jaiden-stipp/FPGA-Graphics-SoC/docs/benchmarks/castle-doors-001/material-preview.png

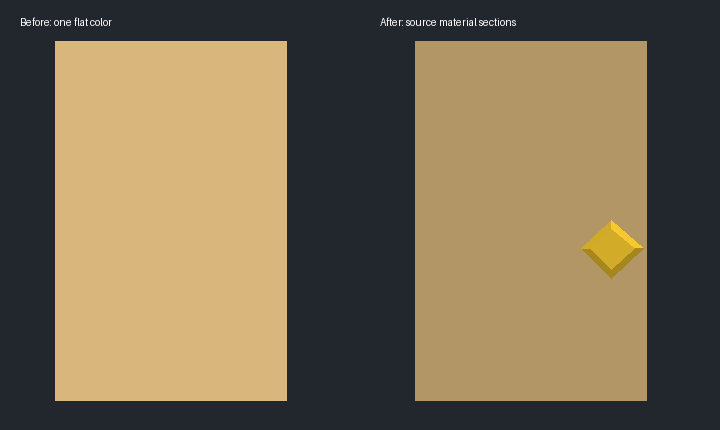
docs/benchmarks/castle-doors-001/material-preview.png
