jaiden-stipp/FPGA-Graphics-SoC/docs/benchmarks/sdram-exec-001/diagnostic-disassembly.txt

C:\Users\Orb1t\Documents\Codex\FPGA-Game-SoC\build\sdram-exec-test.elf:	file format elf32-littleriscv

Disassembly of section .boot:

00000000 <_start>:
       0: 00010117     	auipc	sp, 0x10
       4: 00010113     	mv	sp, sp
       8: 400002b7     	lui	t0, 0x40000
       c: 09c28293     	addi	t0, t0, 0x9c
      10: 0002a303     	lw	t1, 0x0(t0)
      14: 00437313     	andi	t1, t1, 0x4
      18: 00031e63     	bnez	t1, 0x34 <_start+0x34>
      1c: 400002b7     	lui	t0, 0x40000
      20: 01828293     	addi	t0, t0, 0x18
      24: dead0337     	lui	t1, 0xdead0
      28: 0c330313     	addi	t1, t1, 0xc3
      2c: 0062a023     	sw	t1, 0x0(t0)
      30: 0000006f     	j	0x30 <_start+0x30>
      34: 00000297     	auipc	t0, 0x0
      38: 06028293     	addi	t0, t0, 0x60
      3c: 00000317     	auipc	t1, 0x0
      40: 05c30313     	addi	t1, t1, 0x5c
      44: 0062f863     	bgeu	t0, t1, 0x54 <_start+0x54>
      48: 0002a023     	sw	zero, 0x0(t0)
      4c: 00428293     	addi	t0, t0, 0x4
      50: ff5ff06f     	j	0x44 <_start+0x44>
      54: 81000297     	auipc	t0, 0x81000
      58: fb028293     	addi	t0, t0, -0x50
      5c: 81000317     	auipc	t1, 0x81000
      60: fd430313     	addi	t1, t1, -0x2c
      64: 0062f863     	bgeu	t0, t1, 0x74 <_start+0x74>
      68: 0002a023     	sw	zero, 0x0(t0)
      6c: 00428293     	addi	t0, t0, 0x4
      70: ff5ff06f     	j	0x64 <_start+0x64>
      74: 80000097     	auipc	ra, 0x80000
      78: f8c080e7     	jalr	-0x74(ra) <_assets_start+0xfffffffefeffffc0>
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
80010060: 00000013     	nop
80010064: 00000013     	nop
80010068: 00000013     	nop
8001006c: 00000013     	nop
80010070: 00000013     	nop
80010074: 00000013     	nop
80010078: 00a2a023     	sw	a0, 0x0(t0)
8001007c: 00150513     	addi	a0, a0, 0x1
80010080: 00008067     	ret
