jaiden-stipp/FPGA-Graphics-SoC/docs/benchmarks/arch-upgrade-001-stage-5/probe-disassembly.txt

C:\Users\Orb1t\Documents\Codex\FPGA-Game-SoC\build\arch-stage5\probe.elf:	file format elf32-littleriscv

Disassembly of section .text:

00000000 <_start>:
       0: 00010117     	auipc	sp, 0x10
       4: 00010113     	mv	sp, sp
       8: 00002297     	auipc	t0, 0x2
       c: 46028293     	addi	t0, t0, 0x460
      10: 00003317     	auipc	t1, 0x3
      14: 48430313     	addi	t1, t1, 0x484
      18: 0062f863     	bgeu	t0, t1, 0x28 <_start+0x28>
      1c: 0002a023     	sw	zero, 0x0(t0)
      20: 00428293     	addi	t0, t0, 0x4
      24: ff5ff06f     	j	0x18 <_start+0x18>
      28: 00000097     	auipc	ra, 0x0
      2c: 320080e7     	jalr	0x320(ra) <main>
      30: 0000006f     	j	0x30 <_start+0x30>

00000034 <geometry_transform>:
      34: 400002b7     	lui	t0, 0x40000
      38: 09c2a883     	lw	a7, 0x9c(t0)
      3c: 0028f313     	andi	t1, a7, 0x2
      40: 00031663     	bnez	t1, 0x4c <geometry_transform+0x18>
      44: 00000513     	li	a0, 0x0
      48: 00008067     	ret
      4c: 00050893     	mv	a7, a0
      50: f7f58313     	addi	t1, a1, -0x81
      54: f8000393     	li	t2, -0x80
      58: fff00513     	li	a0, -0x1
      5c: 16736263     	bltu	t1, t2, 0x1c0 <geometry_transform+0x18c>
      60: 1002a303     	lw	t1, 0x100(t0)
      64: 475703b7     	lui	t2, 0x47570
      68: 10138393     	addi	t2, t2, 0x101
      6c: 14731a63     	bne	t1, t2, 0x1c0 <geometry_transform+0x18c>
      70: 00200313     	li	t1, 0x2
      74: 400003b7     	lui	t2, 0x40000
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
     730: 04c12d83     	lw	s11, 0x4c(sp)
     734: 08010113     	addi	sp, sp, 0x80
     738: 00008067     	ret
     73c: fff00513     	li	a0, -0x1
     740: fc1ff06f     	j	0x700 <main+0x3b8>

00000744 <fixed_mul>:
     744: 02b50533     	<unknown>
     748: 00008067     	ret
