jaiden-stipp/FPGA-Graphics-SoC/docs/benchmarks/arch-upgrade-001-stage-2b/dma-local-normal-disassembly.txt

build/mario-castle-sdram-direct-dma-mul.elf:	file format elf32-littleriscv

Disassembly of section .text:

00000000 <_start>:
       0: 00010117     	auipc	sp, 0x10
       4: 00010113     	mv	sp, sp
       8: 00007297     	auipc	t0, 0x7
       c: a5028293     	addi	t0, t0, -0x5b0
      10: 00009317     	auipc	t1, 0x9
      14: 82c30313     	addi	t1, t1, -0x7d4
      18: 0062f863     	bgeu	t0, t1, 0x28 <_start+0x28>
      1c: 0002a023     	sw	zero, 0x0(t0)
      20: 00428293     	addi	t0, t0, 0x4
      24: ff5ff06f     	j	0x18 <_start+0x18>
      28: 00002097     	auipc	ra, 0x2
      2c: 3c4080e7     	jalr	0x3c4(ra) <main>
      30: 0000006f     	j	0x30 <_start+0x30>

00000034 <gfx_command>:
      34: fb010113     	addi	sp, sp, -0x50
      38: 04112623     	sw	ra, 0x4c(sp)
      3c: 04812423     	sw	s0, 0x48(sp)
      40: 04912223     	sw	s1, 0x44(sp)
      44: 05212023     	sw	s2, 0x40(sp)
      48: 03312e23     	sw	s3, 0x3c(sp)
      4c: 03412c23     	sw	s4, 0x38(sp)
      50: 03512a23     	sw	s5, 0x34(sp)
      54: 03612823     	sw	s6, 0x30(sp)
      58: 03712623     	sw	s7, 0x2c(sp)
      5c: 03812423     	sw	s8, 0x28(sp)
      60: 03912223     	sw	s9, 0x24(sp)
      64: 03a12023     	sw	s10, 0x20(sp)
      68: 01b12e23     	sw	s11, 0x1c(sp)
      6c: 00058913     	mv	s2, a1
      70: 000075b7     	lui	a1, 0x7
      74: a585c583     	lbu	a1, -0x5a8(a1)
      78: 28058663     	beqz	a1, 0x304 <gfx_command+0x2d0>
      7c: 00007737     	lui	a4, 0x7
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
    695c: 00008067     	ret
    6960: 0c250513     	addi	a0, a0, 0xc2
    6964: 07010113     	addi	sp, sp, 0x70
    6968: 00008067     	ret
    696c: dead1537     	lui	a0, 0xdead1
    6970: 0d050513     	addi	a0, a0, 0xd0
    6974: 07010113     	addi	sp, sp, 0x70
    6978: 00008067     	ret
