jaiden-stipp/FPGA-Graphics-SoC/docs/benchmarks/arch-upgrade-001-stage-2b/packed-normal-disassembly.txt

build/mario-castle-sdram-direct-packed-mul.elf:	file format elf32-littleriscv

Disassembly of section .text:

00000000 <_start>:
       0: 00010117     	auipc	sp, 0x10
       4: 00010113     	mv	sp, sp
       8: 00006297     	auipc	t0, 0x6
       c: 6d428293     	addi	t0, t0, 0x6d4
      10: 00008317     	auipc	t1, 0x8
      14: 49830313     	addi	t1, t1, 0x498
      18: 0062f863     	bgeu	t0, t1, 0x28 <_start+0x28>
      1c: 0002a023     	sw	zero, 0x0(t0)
      20: 00428293     	addi	t0, t0, 0x4
      24: ff5ff06f     	j	0x18 <_start+0x18>
      28: 00002097     	auipc	ra, 0x2
      2c: 048080e7     	jalr	0x48(ra) <main>
      30: 0000006f     	j	0x30 <_start+0x30>

00000034 <gfx_command>:
      34: fe010113     	addi	sp, sp, -0x20
      38: 00812e23     	sw	s0, 0x1c(sp)
      3c: 00912c23     	sw	s1, 0x18(sp)
      40: 01212a23     	sw	s2, 0x14(sp)
      44: 000066b7     	lui	a3, 0x6
      48: 6dc6c703     	lbu	a4, 0x6dc(a3)
      4c: 400006b7     	lui	a3, 0x40000
      50: 01468693     	addi	a3, a3, 0x14
      54: 06070463     	beqz	a4, 0xbc <gfx_command+0x88>
      58: 00000813     	li	a6, 0x0
      5c: 00000793     	li	a5, 0x0
      60: 00000313     	li	t1, 0x0
      64: 00006737     	lui	a4, 0x6
      68: 04700893     	li	a7, 0x47
      6c: 04600f93     	li	t6, 0x46
      70: 00200413     	li	s0, 0x2
      74: 00c109a3     	sb	a2, 0x13(sp)
      78: 000104b7     	lui	s1, 0x10
      7c: 00f10393     	addi	t2, sp, 0xf
      80: 0000fe37     	lui	t3, 0xf
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
    65e0: 00008067     	ret
    65e4: 0c250513     	addi	a0, a0, 0xc2
    65e8: 07010113     	addi	sp, sp, 0x70
    65ec: 00008067     	ret
    65f0: dead1537     	lui	a0, 0xdead1
    65f4: 0d050513     	addi	a0, a0, 0xd0
    65f8: 07010113     	addi	sp, sp, 0x70
    65fc: 00008067     	ret
