jaiden-stipp/FPGA-Graphics-SoC/docs/benchmarks/arch-upgrade-001-stage-2b-staging/probe-disassembly.txt

C:\Users\Orb1t\Documents\Codex\FPGA-Game-SoC\build\arch-stage2b-staging\probe.elf:	file format elf32-littleriscv

Disassembly of section .text:

00000000 <_start>:
       0: 00010117     	auipc	sp, 0x10
       4: 00010113     	mv	sp, sp
       8: 0000b297     	auipc	t0, 0xb
       c: fe428293     	addi	t0, t0, -0x1c
      10: 0000e317     	auipc	t1, 0xe
      14: 95030313     	addi	t1, t1, -0x6b0
      18: 0062f863     	bgeu	t0, t1, 0x28 <_start+0x28>
      1c: 0002a023     	sw	zero, 0x0(t0)
      20: 00428293     	addi	t0, t0, 0x4
      24: ff5ff06f     	j	0x18 <_start+0x18>
      28: 00000097     	auipc	ra, 0x0
      2c: 3ac080e7     	jalr	0x3ac(ra) <main>
      30: 0000006f     	j	0x30 <_start+0x30>

00000034 <gfx_command>:
      34: fe010113     	addi	sp, sp, -0x20
      38: 00812e23     	sw	s0, 0x1c(sp)
      3c: 00912c23     	sw	s1, 0x18(sp)
      40: 01212a23     	sw	s2, 0x14(sp)
      44: 0000d6b7     	lui	a3, 0xd
      48: 40c6c703     	lbu	a4, 0x40c(a3)
      4c: 400006b7     	lui	a3, 0x40000
      50: 01468693     	addi	a3, a3, 0x14
      54: 06070463     	beqz	a4, 0xbc <gfx_command+0x88>
      58: 00000813     	li	a6, 0x0
      5c: 00000793     	li	a5, 0x0
      60: 00000313     	li	t1, 0x0
      64: 0000d737     	lui	a4, 0xd
      68: 04700893     	li	a7, 0x47
      6c: 04600f93     	li	t6, 0x46
      70: 00200413     	li	s0, 0x2
      74: 00c109a3     	sb	a2, 0x13(sp)
      78: 000104b7     	lui	s1, 0x10
      7c: 00f10393     	addi	t2, sp, 0xf
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
     3b8: 00b685b3     	add	a1, a3, a1
     3bc: 08a5ac23     	sw	a0, 0x98(a1)
     3c0: 0006a503     	lw	a0, 0x0(a3)
     3c4: 00153513     	seqz	a0, a0
     3c8: fff50513     	addi	a0, a0, -0x1
     3cc: 00c56533     	or	a0, a0, a2
     3d0: dbdff06f     	j	0x18c <gfx_command+0x158>
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
