jaiden-stipp/FPGA-Graphics-SoC/docs/benchmarks/integer-mul-001/firmware-disassembly.txt

build/mario-castle-sdram-direct-profile-detail-mul.elf:	file format elf32-littleriscv

Disassembly of section .text:

00000000 <_start>:
       0: 00010117     	auipc	sp, 0x10
       4: 00010113     	mv	sp, sp
       8: 00007297     	auipc	t0, 0x7
       c: ae028293     	addi	t0, t0, -0x520
      10: 00009317     	auipc	t1, 0x9
      14: ba430313     	addi	t1, t1, -0x45c
      18: 0062f863     	bgeu	t0, t1, 0x28 <_start+0x28>
      1c: 0002a023     	sw	zero, 0x0(t0)
      20: 00428293     	addi	t0, t0, 0x4
      24: ff5ff06f     	j	0x18 <_start+0x18>
      28: 00002097     	auipc	ra, 0x2
      2c: fac080e7     	jalr	-0x54(ra) <main>
      30: 0000006f     	j	0x30 <_start+0x30>

00000034 <gfx_command>:
      34: fe010113     	addi	sp, sp, -0x20
      38: 00812e23     	sw	s0, 0x1c(sp)
      3c: 00912c23     	sw	s1, 0x18(sp)
      40: 01212a23     	sw	s2, 0x14(sp)
      44: 00000293     	li	t0, 0x0
      48: 400006b7     	lui	a3, 0x40000
      4c: 04700793     	li	a5, 0x47
      50: 04600813     	li	a6, 0x46
      54: 00200e13     	li	t3, 0x2
      58: 00010eb7     	lui	t4, 0x10
      5c: 00f10313     	addi	t1, sp, 0xf
      60: 0000f3b7     	lui	t2, 0xf
      64: 000078b7     	lui	a7, 0x7
      68: a0c88893     	addi	a7, a7, -0x5f4
      6c: 0586a703     	lw	a4, 0x58(a3)
      70: 00f107a3     	sb	a5, 0xf(sp)
      74: 01010823     	sb	a6, 0x10(sp)
      78: 01c108a3     	sb	t3, 0x11(sp)
      7c: 00a10923     	sb	a0, 0x12(sp)
      80: 00c109a3     	sb	a2, 0x13(sp)
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
     184: 00687fb3     	and	t6, a6, t1
     188: 00bfdf93     	srli	t6, t6, 0xb
     18c: 01f88fb3     	add	t6, a7, t6
     190: 000f9483     	lh	s1, 0x0(t6)
     194: 00100f93     	li	t6, 0x1
     198: 00038413     	mv	s0, t2
     19c: 00481813     	slli	a6, a6, 0x4
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
