jaiden-stipp/FPGA-Graphics-SoC/docs/benchmarks/arch-upgrade-001-stage-0/acceptance.md

# Scoped acceptance

Deterministic shared-terrain/controller/orbit-camera preparation, complete GPU buffer capture and exact comparison are verified. Seven castle snapshots, eight authored fixtures and two repeated static Quake views are archived. Full animated game frames, actual mission transitions, physical framebuffer readback and queue-full saturation remain pending. See ../../architecture-stage-0-1.md for scope and reproduction commands.
