jaiden-stipp/FPGA-Graphics-SoC/docs/benchmarks/cache-lines-001/compiler-version.txt

clang version 21.1.6
Target: x86_64-pc-windows-msvc
Thread model: posix
InstalledDir: C:\Program Files\LLVM\bin
