jaiden-stipp/FPGA-Graphics-SoC/docs/benchmarks/arch-upgrade-001-stage-1/acceptance.md

# Promotion declined

Fractional terrain draws pass scoped arithmetic, interface, source preservation, full-terrain comparison and fitted timing checks. Both physical packing experiments regress CPU render time. They remain optional and do not replace default packing or the running game/image. Three trials per configuration, failed first fit, successful registered fit, hashes and restoration evidence are retained. See ../../architecture-stage-0-1.md for measurements, tradeoffs and remaining acceptance work.
