jaiden-stipp/FPGA-Graphics-SoC/docs/benchmarks/cache-lines-001/baseline32.fit.summary.txt

Fitter Status : Successful - Fri Oct 09 23:41:36 2026
Quartus Prime Version : 18.1.0 Build 625 09/12/2018 SJ Lite Edition
Revision Name : BurstSoC
Top-level Entity Name : de2_115_soc_top
Family : Cyclone IV E
Device : EP4CE115F29C7
Timing Models : Final
Total logic elements : 20,979 / 114,480 ( 18 % )
    Total combinational functions : 17,731 / 114,480 ( 15 % )
    Dedicated logic registers : 11,345 / 114,480 ( 10 % )
Total registers : 11377
Total pins : 109 / 529 ( 21 % )
Total virtual pins : 0
Total memory bits : 2,659,668 / 3,981,312 ( 67 % )
Embedded Multiplier 9-bit elements : 74 / 532 ( 14 % )
Total PLLs : 2 / 4 ( 50 % )
