jaiden-stipp/FPGA-Graphics-SoC/docs/benchmarks/cache-lines-001/baseline32.map.summary.txt

Analysis & Synthesis Status : Successful - Fri Oct 09 23:37:18 2026
Quartus Prime Version : 18.1.0 Build 625 09/12/2018 SJ Lite Edition
Revision Name : BurstSoC
Top-level Entity Name : de2_115_soc_top
Family : Cyclone IV E
Total logic elements : 23,577
    Total combinational functions : 17,667
    Dedicated logic registers : 11,473
Total registers : 11473
Total pins : 109
Total virtual pins : 0
Total memory bits : 2,659,668
Embedded Multiplier 9-bit elements : 74
Total PLLs : 2
