jaiden-stipp/FPGA-Graphics-SoC/docs/benchmarks/cache-lines-001/line16.sta.summary.txt

------------------------------------------------------------
Timing Analyzer Summary
------------------------------------------------------------

Type  : Slow 1200mV 85C Model Setup 'CLOCK_50'
Slack : 0.761
TNS   : 0.000

Type  : Slow 1200mV 85C Model Setup 'soc|memory|external_memory.controller|read_clock|pll|auto_generated|pll1|clk[0]'
Slack : 1.407
TNS   : 0.000

Type  : Slow 1200mV 85C Model Setup 'SDRAM_CLK'
Slack : 3.597
TNS   : 0.000

Type  : Slow 1200mV 85C Model Setup 'ENET0_TX_CLK'
Slack : 3.993
TNS   : 0.000

Type  : Slow 1200mV 85C Model Setup 'ENET0_RX_CLK'
Slack : 5.655
TNS   : 0.000

Type  : Slow 1200mV 85C Model Setup 'soc|graphics|renderer|pipeline|clock_generator|altpll_component|auto_generated|pll1|clk[0]'
Slack : 11.222
TNS   : 0.000

Type  : Slow 1200mV 85C Model Hold 'CLOCK_50'
Slack : 0.275
TNS   : 0.000

Type  : Slow 1200mV 85C Model Hold 'ENET0_RX_CLK'
Slack : 0.336
TNS   : 0.000

Type  : Slow 1200mV 85C Model Hold 'ENET0_TX_CLK'
Slack : 0.384
TNS   : 0.000

Type  : Slow 1200mV 85C Model Hold 'soc|graphics|renderer|pipeline|clock_generator|altpll_component|auto_generated|pll1|clk[0]'
Slack : 0.409
TNS   : 0.000

Type  : Slow 1200mV 85C Model Hold 'SDRAM_CLK'
Slack : 10.489
TNS   : 0.000

Type  : Slow 1200mV 85C Model Hold 'soc|memory|external_memory.controller|read_clock|pll|auto_generated|pll1|clk[0]'
Slack : 13.420
TNS   : 0.000

Type  : Slow 1200mV 85C Model Recovery 'CLOCK_50'
Slack : 3.249
TNS   : 0.000

Type  : Slow 1200mV 85C Model Removal 'CLOCK_50'
Slack : 7.535
TNS   : 0.000

Type  : Slow 1200mV 85C Model Minimum Pulse Width 'CLOCK_50'
Slack : 9.526
TNS   : 0.000

Type  : Slow 1200mV 85C Model Minimum Pulse Width 'soc|memory|external_memory.controller|read_clock|pll|auto_generated|pll1|clk[0]'
Slack : 9.798
TNS   : 0.000

Type  : Slow 1200mV 85C Model Minimum Pulse Width 'SDRAM_CLK'
Slack : 15.790
TNS   : 0.000

Type  : Slow 1200mV 85C Model Minimum Pulse Width 'soc|graphics|renderer|pipeline|clock_generator|altpll_component|auto_generated|pll1|clk[0]'
Slack : 19.572
TNS   : 0.000

Type  : Slow 1200mV 85C Model Minimum Pulse Width 'ENET0_RX_CLK'
Slack : 19.630
TNS   : 0.000

Type  : Slow 1200mV 85C Model Minimum Pulse Width 'ENET0_TX_CLK'
Slack : 19.651
TNS   : 0.000

Type  : Slow 1200mV 0C Model Setup 'CLOCK_50'
Slack : 1.474
TNS   : 0.000

Type  : Slow 1200mV 0C Model Setup 'soc|memory|external_memory.controller|read_clock|pll|auto_generated|pll1|clk[0]'
Slack : 1.938
TNS   : 0.000

Type  : Slow 1200mV 0C Model Setup 'SDRAM_CLK'
Slack : 3.940
TNS   : 0.000

Type  : Slow 1200mV 0C Model Setup 'ENET0_RX_CLK'
Slack : 6.103
TNS   : 0.000

Type  : Slow 1200mV 0C Model Setup 'ENET0_TX_CLK'
Slack : 6.469
TNS   : 0.000

Type  : Slow 1200mV 0C Model Setup 'soc|graphics|renderer|pipeline|clock_generator|altpll_component|auto_generated|pll1|clk[0]'
Slack : 13.753
TNS   : 0.000

Type  : Slow 1200mV 0C Model Hold 'CLOCK_50'
Slack : 0.287
TNS   : 0.000

Type  : Slow 1200mV 0C Model Hold 'ENET0_TX_CLK'
Slack : 0.337
TNS   : 0.000

Type  : Slow 1200mV 0C Model Hold 'ENET0_RX_CLK'
Slack : 0.340
TNS   : 0.000

Type  : Slow 1200mV 0C Model Hold 'soc|graphics|renderer|pipeline|clock_generator|altpll_component|auto_generated|pll1|clk[0]'
Slack : 0.363
TNS   : 0.000

Type  : Slow 1200mV 0C Model Hold 'SDRAM_CLK'
Slack : 10.213
TNS   : 0.000

Type  : Slow 1200mV 0C Model Hold 'soc|memory|external_memory.controller|read_clock|pll|auto_generated|pll1|clk[0]'
Slack : 12.965
TNS   : 0.000

Type  : Slow 1200mV 0C Model Recovery 'CLOCK_50'
Slack : 3.773
TNS   : 0.000

Type  : Slow 1200mV 0C Model Removal 'CLOCK_50'
Slack : 6.848
TNS   : 0.000

Type  : Slow 1200mV 0C Model Minimum Pulse Width 'CLOCK_50'
Slack : 9.556
TNS   : 0.000

Type  : Slow 1200mV 0C Model Minimum Pulse Width 'soc|memory|external_memory.controller|read_clock|pll|auto_generated|pll1|clk[0]'
Slack : 9.808
TNS   : 0.000

Type  : Slow 1200mV 0C Model Minimum Pulse Width 'SDRAM_CLK'
Slack : 15.790
TNS   : 0.000

Type  : Slow 1200mV 0C Model Minimum Pulse Width 'soc|graphics|renderer|pipeline|clock_generator|altpll_component|auto_generated|pll1|clk[0]'
Slack : 19.574
TNS   : 0.000

Type  : Slow 1200mV 0C Model Minimum Pulse Width 'ENET0_RX_CLK'
Slack : 19.651
TNS   : 0.000

Type  : Slow 1200mV 0C Model Minimum Pulse Width 'ENET0_TX_CLK'
Slack : 19.669
TNS   : 0.000

Type  : Fast 1200mV 0C Model Setup 'soc|memory|external_memory.controller|read_clock|pll|auto_generated|pll1|clk[0]'
Slack : 3.593
TNS   : 0.000

Type  : Fast 1200mV 0C Model Setup 'CLOCK_50'
Slack : 5.068
TNS   : 0.000

Type  : Fast 1200mV 0C Model Setup 'SDRAM_CLK'
Slack : 5.865
TNS   : 0.000

Type  : Fast 1200mV 0C Model Setup 'ENET0_RX_CLK'
Slack : 8.470
TNS   : 0.000

Type  : Fast 1200mV 0C Model Setup 'ENET0_TX_CLK'
Slack : 16.828
TNS   : 0.000

Type  : Fast 1200mV 0C Model Setup 'soc|graphics|renderer|pipeline|clock_generator|altpll_component|auto_generated|pll1|clk[0]'
Slack : 24.638
TNS   : 0.000

Type  : Fast 1200mV 0C Model Hold 'CLOCK_50'
Slack : 0.110
TNS   : 0.000

Type  : Fast 1200mV 0C Model Hold 'ENET0_RX_CLK'
Slack : 0.134
TNS   : 0.000

Type  : Fast 1200mV 0C Model Hold 'ENET0_TX_CLK'
Slack : 0.173
TNS   : 0.000

Type  : Fast 1200mV 0C Model Hold 'soc|graphics|renderer|pipeline|clock_generator|altpll_component|auto_generated|pll1|clk[0]'
Slack : 0.188
TNS   : 0.000

Type  : Fast 1200mV 0C Model Hold 'SDRAM_CLK'
Slack : 9.414
TNS   : 0.000

Type  : Fast 1200mV 0C Model Hold 'soc|memory|external_memory.controller|read_clock|pll|auto_generated|pll1|clk[0]'
Slack : 11.270
TNS   : 0.000

Type  : Fast 1200mV 0C Model Recovery 'CLOCK_50'
Slack : 6.881
TNS   : 0.000

Type  : Fast 1200mV 0C Model Removal 'CLOCK_50'
Slack : 3.951
TNS   : 0.000

Type  : Fast 1200mV 0C Model Minimum Pulse Width 'CLOCK_50'
Slack : 9.194
TNS   : 0.000

Type  : Fast 1200mV 0C Model Minimum Pulse Width 'soc|memory|external_memory.controller|read_clock|pll|auto_generated|pll1|clk[0]'
Slack : 9.798
TNS   : 0.000

Type  : Fast 1200mV 0C Model Minimum Pulse Width 'SDRAM_CLK'
Slack : 16.000
TNS   : 0.000

Type  : Fast 1200mV 0C Model Minimum Pulse Width 'ENET0_RX_CLK'
Slack : 19.377
TNS   : 0.000

Type  : Fast 1200mV 0C Model Minimum Pulse Width 'ENET0_TX_CLK'
Slack : 19.384
TNS   : 0.000

Type  : Fast 1200mV 0C Model Minimum Pulse Width 'soc|graphics|renderer|pipeline|clock_generator|altpll_component|auto_generated|pll1|clk[0]'
Slack : 19.614
TNS   : 0.000

------------------------------------------------------------
