jaiden-stipp/FPGA-Graphics-SoC/docs/benchmarks/cache-lines-001/line8.fit.summary.txt

Fitter Status : Successful - Sat Oct 10 00:02:12 2026
Quartus Prime Version : 18.1.0 Build 625 09/12/2018 SJ Lite Edition
Revision Name : CacheLine8SoC
Top-level Entity Name : de2_115_soc_top
Family : Cyclone IV E
Device : EP4CE115F29C7
Timing Models : Final
Total logic elements : 22,790 / 114,480 ( 20 % )
    Total combinational functions : 19,508 / 114,480 ( 17 % )
    Dedicated logic registers : 11,731 / 114,480 ( 10 % )
Total registers : 11763
Total pins : 109 / 529 ( 21 % )
Total virtual pins : 0
Total memory bits : 2,665,428 / 3,981,312 ( 67 % )
Embedded Multiplier 9-bit elements : 74 / 532 ( 14 % )
Total PLLs : 2 / 4 ( 50 % )
