jaiden-stipp/FPGA-Graphics-SoC/docs/benchmarks/cache-lines-001/line8.sta.summary.txt

------------------------------------------------------------
Timing Analyzer Summary
------------------------------------------------------------

Type  : Slow 1200mV 85C Model Setup 'CLOCK_50'
Slack : 0.653
TNS   : 0.000

Type  : Slow 1200mV 85C Model Setup 'soc|memory|external_memory.controller|read_clock|pll|auto_generated|pll1|clk[0]'
Slack : 1.409
TNS   : 0.000

Type  : Slow 1200mV 85C Model Setup 'SDRAM_CLK'
Slack : 2.985
TNS   : 0.000

Type  : Slow 1200mV 85C Model Setup 'ENET0_TX_CLK'
Slack : 4.584
TNS   : 0.000

Type  : Slow 1200mV 85C Model Setup 'ENET0_RX_CLK'
Slack : 6.019
TNS   : 0.000

Type  : Slow 1200mV 85C Model Setup 'soc|graphics|renderer|pipeline|clock_generator|altpll_component|auto_generated|pll1|clk[0]'
Slack : 12.163
TNS   : 0.000

Type  : Slow 1200mV 85C Model Hold 'CLOCK_50'
Slack : 0.284
TNS   : 0.000

Type  : Slow 1200mV 85C Model Hold 'ENET0_RX_CLK'
Slack : 0.309
TNS   : 0.000

Type  : Slow 1200mV 85C Model Hold 'ENET0_TX_CLK'
Slack : 0.387
TNS   : 0.000

Type  : Slow 1200mV 85C Model Hold 'soc|graphics|renderer|pipeline|clock_generator|altpll_component|auto_generated|pll1|clk[0]'
Slack : 0.409
TNS   : 0.000

Type  : Slow 1200mV 85C Model Hold 'SDRAM_CLK'
Slack : 10.148
TNS   : 0.000

Type  : Slow 1200mV 85C Model Hold 'soc|memory|external_memory.controller|read_clock|pll|auto_generated|pll1|clk[0]'
Slack : 13.418
TNS   : 0.000

Type  : Slow 1200mV 85C Model Recovery 'CLOCK_50'
Slack : 3.669
TNS   : 0.000

Type  : Slow 1200mV 85C Model Removal 'CLOCK_50'
Slack : 6.884
TNS   : 0.000

Type  : Slow 1200mV 85C Model Minimum Pulse Width 'CLOCK_50'
Slack : 9.524
TNS   : 0.000

Type  : Slow 1200mV 85C Model Minimum Pulse Width 'soc|memory|external_memory.controller|read_clock|pll|auto_generated|pll1|clk[0]'
Slack : 9.799
TNS   : 0.000

Type  : Slow 1200mV 85C Model Minimum Pulse Width 'SDRAM_CLK'
Slack : 15.790
TNS   : 0.000

Type  : Slow 1200mV 85C Model Minimum Pulse Width 'soc|graphics|renderer|pipeline|clock_generator|altpll_component|auto_generated|pll1|clk[0]'
Slack : 19.575
TNS   : 0.000

Type  : Slow 1200mV 85C Model Minimum Pulse Width 'ENET0_RX_CLK'
Slack : 19.630
TNS   : 0.000

Type  : Slow 1200mV 85C Model Minimum Pulse Width 'ENET0_TX_CLK'
Slack : 19.651
TNS   : 0.000

Type  : Slow 1200mV 0C Model Setup 'CLOCK_50'
Slack : 1.361
TNS   : 0.000

Type  : Slow 1200mV 0C Model Setup 'soc|memory|external_memory.controller|read_clock|pll|auto_generated|pll1|clk[0]'
Slack : 1.939
TNS   : 0.000

Type  : Slow 1200mV 0C Model Setup 'SDRAM_CLK'
Slack : 3.341
TNS   : 0.000

Type  : Slow 1200mV 0C Model Setup 'ENET0_RX_CLK'
Slack : 6.446
TNS   : 0.000

Type  : Slow 1200mV 0C Model Setup 'ENET0_TX_CLK'
Slack : 7.012
TNS   : 0.000

Type  : Slow 1200mV 0C Model Setup 'soc|graphics|renderer|pipeline|clock_generator|altpll_component|auto_generated|pll1|clk[0]'
Slack : 14.662
TNS   : 0.000

Type  : Slow 1200mV 0C Model Hold 'CLOCK_50'
Slack : 0.298
TNS   : 0.000

Type  : Slow 1200mV 0C Model Hold 'ENET0_RX_CLK'
Slack : 0.306
TNS   : 0.000

Type  : Slow 1200mV 0C Model Hold 'ENET0_TX_CLK'
Slack : 0.340
TNS   : 0.000

Type  : Slow 1200mV 0C Model Hold 'soc|graphics|renderer|pipeline|clock_generator|altpll_component|auto_generated|pll1|clk[0]'
Slack : 0.363
TNS   : 0.000

Type  : Slow 1200mV 0C Model Hold 'SDRAM_CLK'
Slack : 9.842
TNS   : 0.000

Type  : Slow 1200mV 0C Model Hold 'soc|memory|external_memory.controller|read_clock|pll|auto_generated|pll1|clk[0]'
Slack : 12.964
TNS   : 0.000

Type  : Slow 1200mV 0C Model Recovery 'CLOCK_50'
Slack : 4.273
TNS   : 0.000

Type  : Slow 1200mV 0C Model Removal 'CLOCK_50'
Slack : 6.223
TNS   : 0.000

Type  : Slow 1200mV 0C Model Minimum Pulse Width 'CLOCK_50'
Slack : 9.554
TNS   : 0.000

Type  : Slow 1200mV 0C Model Minimum Pulse Width 'soc|memory|external_memory.controller|read_clock|pll|auto_generated|pll1|clk[0]'
Slack : 9.808
TNS   : 0.000

Type  : Slow 1200mV 0C Model Minimum Pulse Width 'SDRAM_CLK'
Slack : 15.790
TNS   : 0.000

Type  : Slow 1200mV 0C Model Minimum Pulse Width 'soc|graphics|renderer|pipeline|clock_generator|altpll_component|auto_generated|pll1|clk[0]'
Slack : 19.574
TNS   : 0.000

Type  : Slow 1200mV 0C Model Minimum Pulse Width 'ENET0_RX_CLK'
Slack : 19.647
TNS   : 0.000

Type  : Slow 1200mV 0C Model Minimum Pulse Width 'ENET0_TX_CLK'
Slack : 19.667
TNS   : 0.000

Type  : Fast 1200mV 0C Model Setup 'soc|memory|external_memory.controller|read_clock|pll|auto_generated|pll1|clk[0]'
Slack : 3.594
TNS   : 0.000

Type  : Fast 1200mV 0C Model Setup 'CLOCK_50'
Slack : 5.013
TNS   : 0.000

Type  : Fast 1200mV 0C Model Setup 'SDRAM_CLK'
Slack : 5.534
TNS   : 0.000

Type  : Fast 1200mV 0C Model Setup 'ENET0_RX_CLK'
Slack : 8.756
TNS   : 0.000

Type  : Fast 1200mV 0C Model Setup 'ENET0_TX_CLK'
Slack : 17.271
TNS   : 0.000

Type  : Fast 1200mV 0C Model Setup 'soc|graphics|renderer|pipeline|clock_generator|altpll_component|auto_generated|pll1|clk[0]'
Slack : 25.212
TNS   : 0.000

Type  : Fast 1200mV 0C Model Hold 'CLOCK_50'
Slack : 0.103
TNS   : 0.000

Type  : Fast 1200mV 0C Model Hold 'ENET0_RX_CLK'
Slack : 0.106
TNS   : 0.000

Type  : Fast 1200mV 0C Model Hold 'ENET0_TX_CLK'
Slack : 0.175
TNS   : 0.000

Type  : Fast 1200mV 0C Model Hold 'soc|graphics|renderer|pipeline|clock_generator|altpll_component|auto_generated|pll1|clk[0]'
Slack : 0.187
TNS   : 0.000

Type  : Fast 1200mV 0C Model Hold 'SDRAM_CLK'
Slack : 9.228
TNS   : 0.000

Type  : Fast 1200mV 0C Model Hold 'soc|memory|external_memory.controller|read_clock|pll|auto_generated|pll1|clk[0]'
Slack : 11.268
TNS   : 0.000

Type  : Fast 1200mV 0C Model Recovery 'CLOCK_50'
Slack : 7.136
TNS   : 0.000

Type  : Fast 1200mV 0C Model Removal 'CLOCK_50'
Slack : 3.663
TNS   : 0.000

Type  : Fast 1200mV 0C Model Minimum Pulse Width 'CLOCK_50'
Slack : 9.195
TNS   : 0.000

Type  : Fast 1200mV 0C Model Minimum Pulse Width 'soc|memory|external_memory.controller|read_clock|pll|auto_generated|pll1|clk[0]'
Slack : 9.798
TNS   : 0.000

Type  : Fast 1200mV 0C Model Minimum Pulse Width 'SDRAM_CLK'
Slack : 16.000
TNS   : 0.000

Type  : Fast 1200mV 0C Model Minimum Pulse Width 'ENET0_RX_CLK'
Slack : 19.375
TNS   : 0.000

Type  : Fast 1200mV 0C Model Minimum Pulse Width 'ENET0_TX_CLK'
Slack : 19.383
TNS   : 0.000

Type  : Fast 1200mV 0C Model Minimum Pulse Width 'soc|graphics|renderer|pipeline|clock_generator|altpll_component|auto_generated|pll1|clk[0]'
Slack : 19.614
TNS   : 0.000

------------------------------------------------------------
