jaiden-stipp/FPGA-Graphics-SoC/docs/benchmarks/cache-001/cache.fit.summary.txt

Fitter Status : Successful - Fri Oct 09 15:50:12 2026
Quartus Prime Version : 18.1.0 Build 625 09/12/2018 SJ Lite Edition
Revision Name : CacheSoC
Top-level Entity Name : de2_115_soc_top
Family : Cyclone IV E
Device : EP4CE115F29C7
Timing Models : Final
Total logic elements : 20,833 / 114,480 ( 18 % )
    Total combinational functions : 17,622 / 114,480 ( 15 % )
    Dedicated logic registers : 11,290 / 114,480 ( 10 % )
Total registers : 11322
Total pins : 109 / 529 ( 21 % )
Total virtual pins : 0
Total memory bits : 2,659,668 / 3,981,312 ( 67 % )
Embedded Multiplier 9-bit elements : 66 / 532 ( 12 % )
Total PLLs : 2 / 4 ( 50 % )
