jaiden-stipp/FPGA-Graphics-SoC/docs/benchmarks/cache-001/cache.sta.summary.txt

------------------------------------------------------------
Timing Analyzer Summary
------------------------------------------------------------

Type  : Slow 1200mV 85C Model Setup 'CLOCK_50'
Slack : 0.577
TNS   : 0.000

Type  : Slow 1200mV 85C Model Setup 'soc|memory|external_memory.controller|read_clock|pll|auto_generated|pll1|clk[0]'
Slack : 1.409
TNS   : 0.000

Type  : Slow 1200mV 85C Model Setup 'SDRAM_CLK'
Slack : 3.072
TNS   : 0.000

Type  : Slow 1200mV 85C Model Setup 'ENET0_TX_CLK'
Slack : 4.161
TNS   : 0.000

Type  : Slow 1200mV 85C Model Setup 'ENET0_RX_CLK'
Slack : 6.043
TNS   : 0.000

Type  : Slow 1200mV 85C Model Setup 'soc|graphics|renderer|pipeline|clock_generator|altpll_component|auto_generated|pll1|clk[0]'
Slack : 12.165
TNS   : 0.000

Type  : Slow 1200mV 85C Model Hold 'CLOCK_50'
Slack : 0.304
TNS   : 0.000

Type  : Slow 1200mV 85C Model Hold 'ENET0_RX_CLK'
Slack : 0.322
TNS   : 0.000

Type  : Slow 1200mV 85C Model Hold 'ENET0_TX_CLK'
Slack : 0.386
TNS   : 0.000

Type  : Slow 1200mV 85C Model Hold 'soc|graphics|renderer|pipeline|clock_generator|altpll_component|auto_generated|pll1|clk[0]'
Slack : 0.408
TNS   : 0.000

Type  : Slow 1200mV 85C Model Hold 'SDRAM_CLK'
Slack : 10.292
TNS   : 0.000

Type  : Slow 1200mV 85C Model Hold 'soc|memory|external_memory.controller|read_clock|pll|auto_generated|pll1|clk[0]'
Slack : 13.418
TNS   : 0.000

Type  : Slow 1200mV 85C Model Recovery 'CLOCK_50'
Slack : 2.605
TNS   : 0.000

Type  : Slow 1200mV 85C Model Removal 'CLOCK_50'
Slack : 6.424
TNS   : 0.000

Type  : Slow 1200mV 85C Model Minimum Pulse Width 'CLOCK_50'
Slack : 9.527
TNS   : 0.000

Type  : Slow 1200mV 85C Model Minimum Pulse Width 'soc|memory|external_memory.controller|read_clock|pll|auto_generated|pll1|clk[0]'
Slack : 9.799
TNS   : 0.000

Type  : Slow 1200mV 85C Model Minimum Pulse Width 'SDRAM_CLK'
Slack : 15.790
TNS   : 0.000

Type  : Slow 1200mV 85C Model Minimum Pulse Width 'soc|graphics|renderer|pipeline|clock_generator|altpll_component|auto_generated|pll1|clk[0]'
Slack : 19.576
TNS   : 0.000

Type  : Slow 1200mV 85C Model Minimum Pulse Width 'ENET0_RX_CLK'
Slack : 19.628
TNS   : 0.000

Type  : Slow 1200mV 85C Model Minimum Pulse Width 'ENET0_TX_CLK'
Slack : 19.658
TNS   : 0.000

Type  : Slow 1200mV 0C Model Setup 'CLOCK_50'
Slack : 1.640
TNS   : 0.000

Type  : Slow 1200mV 0C Model Setup 'soc|memory|external_memory.controller|read_clock|pll|auto_generated|pll1|clk[0]'
Slack : 1.939
TNS   : 0.000

Type  : Slow 1200mV 0C Model Setup 'SDRAM_CLK'
Slack : 3.498
TNS   : 0.000

Type  : Slow 1200mV 0C Model Setup 'ENET0_RX_CLK'
Slack : 6.554
TNS   : 0.000

Type  : Slow 1200mV 0C Model Setup 'ENET0_TX_CLK'
Slack : 6.601
TNS   : 0.000

Type  : Slow 1200mV 0C Model Setup 'soc|graphics|renderer|pipeline|clock_generator|altpll_component|auto_generated|pll1|clk[0]'
Slack : 14.664
TNS   : 0.000

Type  : Slow 1200mV 0C Model Hold 'CLOCK_50'
Slack : 0.307
TNS   : 0.000

Type  : Slow 1200mV 0C Model Hold 'ENET0_RX_CLK'
Slack : 0.320
TNS   : 0.000

Type  : Slow 1200mV 0C Model Hold 'ENET0_TX_CLK'
Slack : 0.339
TNS   : 0.000

Type  : Slow 1200mV 0C Model Hold 'soc|graphics|renderer|pipeline|clock_generator|altpll_component|auto_generated|pll1|clk[0]'
Slack : 0.363
TNS   : 0.000

Type  : Slow 1200mV 0C Model Hold 'SDRAM_CLK'
Slack : 9.977
TNS   : 0.000

Type  : Slow 1200mV 0C Model Hold 'soc|memory|external_memory.controller|read_clock|pll|auto_generated|pll1|clk[0]'
Slack : 12.964
TNS   : 0.000

Type  : Slow 1200mV 0C Model Recovery 'CLOCK_50'
Slack : 3.283
TNS   : 0.000

Type  : Slow 1200mV 0C Model Removal 'CLOCK_50'
Slack : 5.803
TNS   : 0.000

Type  : Slow 1200mV 0C Model Minimum Pulse Width 'CLOCK_50'
Slack : 9.556
TNS   : 0.000

Type  : Slow 1200mV 0C Model Minimum Pulse Width 'soc|memory|external_memory.controller|read_clock|pll|auto_generated|pll1|clk[0]'
Slack : 9.808
TNS   : 0.000

Type  : Slow 1200mV 0C Model Minimum Pulse Width 'SDRAM_CLK'
Slack : 15.790
TNS   : 0.000

Type  : Slow 1200mV 0C Model Minimum Pulse Width 'soc|graphics|renderer|pipeline|clock_generator|altpll_component|auto_generated|pll1|clk[0]'
Slack : 19.573
TNS   : 0.000

Type  : Slow 1200mV 0C Model Minimum Pulse Width 'ENET0_RX_CLK'
Slack : 19.648
TNS   : 0.000

Type  : Slow 1200mV 0C Model Minimum Pulse Width 'ENET0_TX_CLK'
Slack : 19.671
TNS   : 0.000

Type  : Fast 1200mV 0C Model Setup 'soc|memory|external_memory.controller|read_clock|pll|auto_generated|pll1|clk[0]'
Slack : 3.594
TNS   : 0.000

Type  : Fast 1200mV 0C Model Setup 'CLOCK_50'
Slack : 5.026
TNS   : 0.000

Type  : Fast 1200mV 0C Model Setup 'SDRAM_CLK'
Slack : 5.535
TNS   : 0.000

Type  : Fast 1200mV 0C Model Setup 'ENET0_RX_CLK'
Slack : 8.819
TNS   : 0.000

Type  : Fast 1200mV 0C Model Setup 'ENET0_TX_CLK'
Slack : 17.054
TNS   : 0.000

Type  : Fast 1200mV 0C Model Setup 'soc|graphics|renderer|pipeline|clock_generator|altpll_component|auto_generated|pll1|clk[0]'
Slack : 25.262
TNS   : 0.000

Type  : Fast 1200mV 0C Model Hold 'CLOCK_50'
Slack : 0.110
TNS   : 0.000

Type  : Fast 1200mV 0C Model Hold 'ENET0_RX_CLK'
Slack : 0.124
TNS   : 0.000

Type  : Fast 1200mV 0C Model Hold 'ENET0_TX_CLK'
Slack : 0.174
TNS   : 0.000

Type  : Fast 1200mV 0C Model Hold 'soc|graphics|renderer|pipeline|clock_generator|altpll_component|auto_generated|pll1|clk[0]'
Slack : 0.188
TNS   : 0.000

Type  : Fast 1200mV 0C Model Hold 'SDRAM_CLK'
Slack : 9.309
TNS   : 0.000

Type  : Fast 1200mV 0C Model Hold 'soc|memory|external_memory.controller|read_clock|pll|auto_generated|pll1|clk[0]'
Slack : 11.269
TNS   : 0.000

Type  : Fast 1200mV 0C Model Recovery 'CLOCK_50'
Slack : 6.617
TNS   : 0.000

Type  : Fast 1200mV 0C Model Removal 'CLOCK_50'
Slack : 3.396
TNS   : 0.000

Type  : Fast 1200mV 0C Model Minimum Pulse Width 'CLOCK_50'
Slack : 9.195
TNS   : 0.000

Type  : Fast 1200mV 0C Model Minimum Pulse Width 'soc|memory|external_memory.controller|read_clock|pll|auto_generated|pll1|clk[0]'
Slack : 9.797
TNS   : 0.000

Type  : Fast 1200mV 0C Model Minimum Pulse Width 'SDRAM_CLK'
Slack : 16.000
TNS   : 0.000

Type  : Fast 1200mV 0C Model Minimum Pulse Width 'ENET0_RX_CLK'
Slack : 19.377
TNS   : 0.000

Type  : Fast 1200mV 0C Model Minimum Pulse Width 'ENET0_TX_CLK'
Slack : 19.384
TNS   : 0.000

Type  : Fast 1200mV 0C Model Minimum Pulse Width 'soc|graphics|renderer|pipeline|clock_generator|altpll_component|auto_generated|pll1|clk[0]'
Slack : 19.614
TNS   : 0.000

------------------------------------------------------------
