jaiden-stipp/FPGA-Graphics-SoC/docs/benchmarks/cache-001/rejected-register-array.map.summary.txt

Analysis & Synthesis Status : Successful - Fri Oct 09 15:42:41 2026
Quartus Prime Version : 18.1.0 Build 625 09/12/2018 SJ Lite Edition
Revision Name : CacheSoC
Top-level Entity Name : de2_115_soc_top
Family : Cyclone IV E
Total logic elements : 84,802
    Total combinational functions : 46,209
    Dedicated logic registers : 44,124
Total registers : 44124
Total pins : 109
Total virtual pins : 0
Total memory bits : 2,626,900
Embedded Multiplier 9-bit elements : 66
Total PLLs : 2
