jaiden-stipp/FPGA-Graphics-SoC/docs/benchmarks/depth-001/depth-banding.png

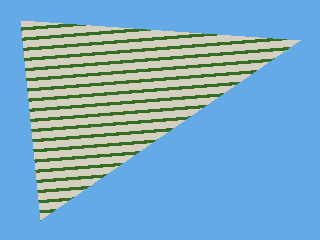
docs/benchmarks/depth-001/depth-banding.png
