jaiden-stipp/FPGA-Graphics-SoC/docs/benchmarks/lakitu-controls-culling-001/replay/reflected-camera.png

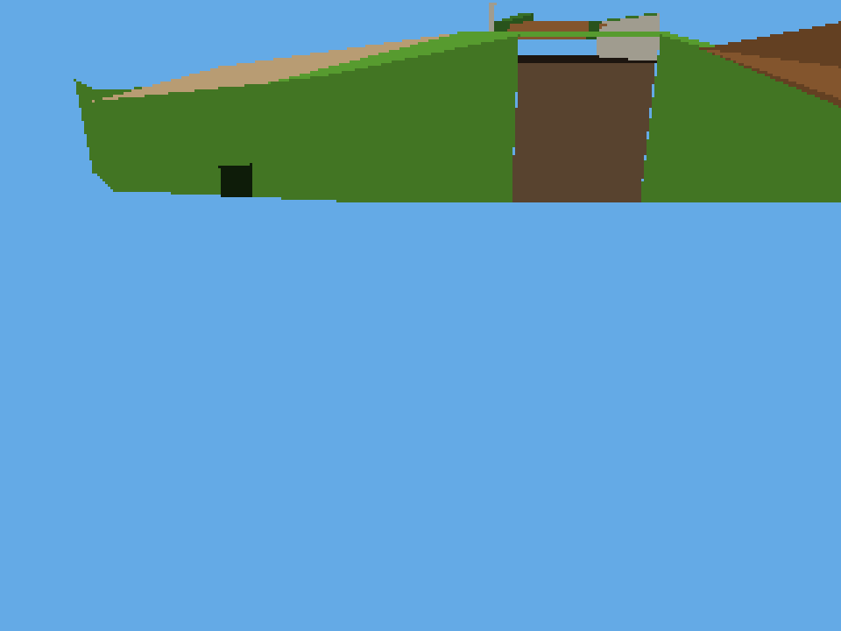
docs/benchmarks/lakitu-controls-culling-001/replay/reflected-camera.png
