jaiden-stipp/FPGA-Graphics-SoC/docs/benchmarks/render-correctness-001/after-frame-1.png

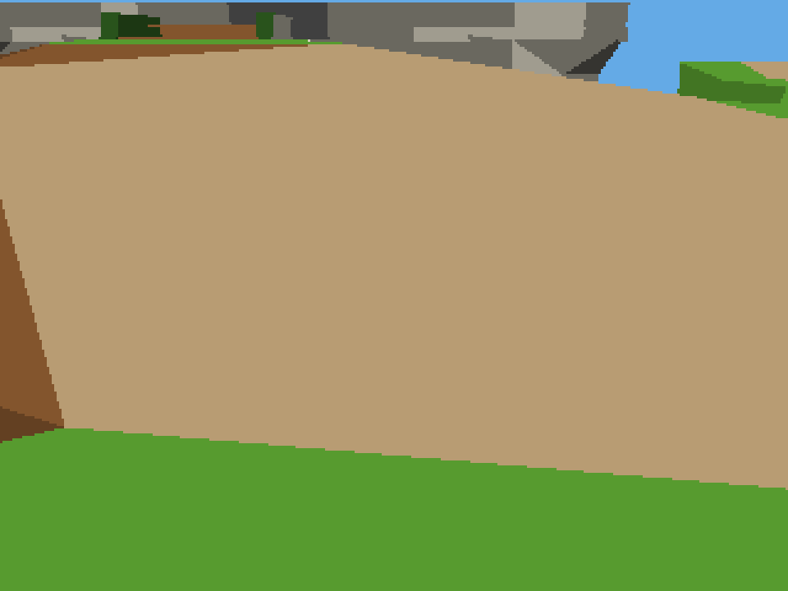
docs/benchmarks/render-correctness-001/after-frame-1.png
