jaiden-stipp/FPGA-Graphics-SoC/docs/benchmarks/render-correctness-001/before-frame-1.png

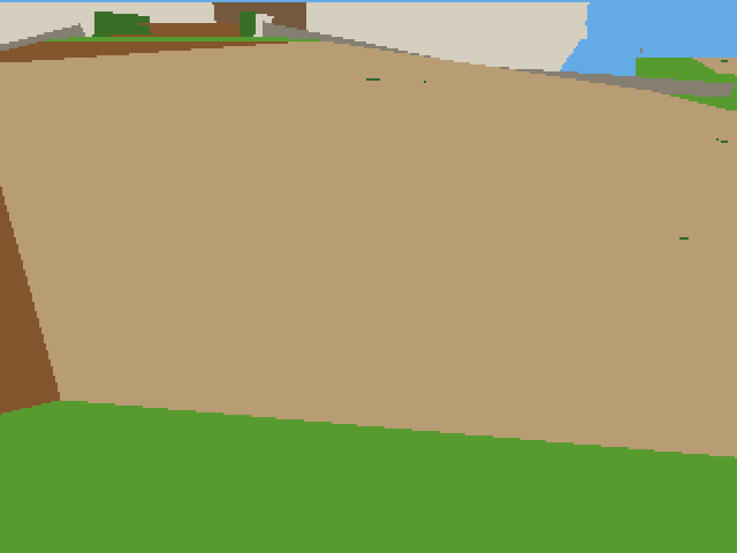
docs/benchmarks/render-correctness-001/before-frame-1.png
