jaiden-stipp/FPGA-Graphics-SoC/(commit log)

2026-10-09 Add SDRAM cache and benchmark evidence
    This change adds a blocking SDRAM cache between the CPU bridge and controller, exposes live cache counters over MMIO, and wires the cache option through the SoC and Quartus project generation. It also adds cache-focused simulation tests, updates the CI workflow to run them, and documents the architecture, memory map, and evidence-backed hardware improvement record with benchmark logs and measurements.
2026-10-10 Parameterize equal-capacity cache lines for measured BL2 BL4 BL8 comparison
2026-10-10 Record physical equal-capacity cache line comparison and retain BL8 default
2026-10-10 Preserve CPU stall assessment before physical instrumentation
2026-10-10 Instrument CPU stalls and atomic frame profiles; add optional FIFO reservation experiment
2026-10-10 Use one UDP reply socket and validate initialization for profiling
2026-10-10 Record physical CPU stall breakdown and scoped FIFO batching results
2026-10-10 Add optional completed-frame render function profiling
2026-10-10 Add physical MUL arithmetic probe and emitted instruction audit
2026-10-10 Match software and MUL probe timed loops with validation outside timers
2026-10-11 Fix bounded screen-edge clipping and depth holes; record physical cost
2026-10-11 Document staged parallel FPGA architecture upgrade plan
2026-10-11 Add deterministic terrain command replay and full GPU frame capture baseline
2026-10-11 Record Stage 2A physical comparisons, timing and deployment decision
2026-10-11 Measure command-buffer staging on unchanged Stage 2A hardware
2026-10-11 Implement experimental read-only SDRAM GPU command DMA with owned double buffers
2026-10-11 Keep DMA command staging state local after measured bookkeeping regression
2026-10-11 Record Stage 2B staging, DMA comparisons, timing and rejected promotion
2026-10-11 Record Stage 3 accepted packed baseline and setup overlap contract
2026-10-11 Implement selectable Stage 3 setup producer and two-record raster queue
2026-10-11 Require front-facing nonempty geometry in Stage 3 physical probe
2026-10-11 Use Quartus-compatible Stage 3 enum widths and separate physical trial modes
2026-10-11 Audit Stage 3 probe subset and actual LLVM instruction format
2026-10-11 Record Stage 3 exact rendering, physical comparisons, timing and selected deployment
2026-10-11 Preserve accepted Stage 3 baseline and Stage 4 banking contract
2026-10-11 Record verified Stage 4 two-lane rendering, matched physical trials and selected Mario deployment
2026-10-11 Preserve ignored Stage 4 fit reports and raw artifacts required by evidence manifest
2026-10-11 Preserve Stage 4 baseline and select measured Stage 5 geometry kernel
2026-10-11 Add complete CPU game-stream equivalence, gated profiling and reproducible Stage 5 commands
2026-10-12 Record measured Stage 5 CPU geometry acceleration, exact game/GPU equivalence and selected deployment
2026-10-12 Preserve Stage 5 baseline and scope Stage 6 cadence experiment
2026-10-12 Record Stage 6 atomic cadence trials, timing audit and selected Castle deployment
2026-10-12 Preserve Stage 6 baseline for gameplay rendering corrections
2026-10-13 Add local boot and cached SDRAM execution with measured board validation
2026-10-13 Restore castle warp-door rendering and preserve door material contrast
2026-10-13 Deploy original-engine grounds build and record active FPGA selection
2026-10-14 Extend original Mario grounds movement with water health ledges and respawn
2026-10-14 Port engine-selected Mario animation and normal Lakitu camera
2026-10-14 Fix Lakitu view handedness and camera-relative controls
