jaiden-stipp/FPGA-Graphics-SoC/(notices)

Notices in the files:
docs/benchmarks/integer-mul-001/firmware-disassembly.txt:
cc0: f99ff06f j 0xc58
